Helloworlllld/mengsheng_cup_2022_b/(list of files, drawings)

Other design files:
MSB.eprj
