Helloworlllld/mengsheng_cup_2022_b/MSB/Core/Inc/main.h

#define LED_Pin GPIO_PIN_13
#define LED_GPIO_Port GPIOC
#define KEY_Pin GPIO_PIN_0
#define KEY_GPIO_Port GPIOA
#define B_LED_Pin GPIO_PIN_7
#define B_LED_GPIO_Port GPIOA
#define G_LED_Pin GPIO_PIN_0
#define G_LED_GPIO_Port GPIOB
#define R_LED_Pin GPIO_PIN_1
#define R_LED_GPIO_Port GPIOB
#define LCD_SCL_Pin GPIO_PIN_10
#define LCD_SCL_GPIO_Port GPIOB
#define LCD_SDA_Pin GPIO_PIN_15
#define LCD_SDA_GPIO_Port GPIOB
#define LCD_RES_Pin GPIO_PIN_15
#define LCD_RES_GPIO_Port GPIOA
#define LCD_DC_Pin GPIO_PIN_3
#define LCD_DC_GPIO_Port GPIOB
#define LCD_CS_Pin GPIO_PIN_4
#define LCD_CS_GPIO_Port GPIOB
#define LCD_BLK_Pin GPIO_PIN_5
#define LCD_BLK_GPIO_Port GPIOB
#define T_INT_Pin GPIO_PIN_8
#define T_INT_GPIO_Port GPIOB
#define T_INT_EXTI_IRQn EXTI9_5_IRQn
#define T_LED_PWM_Pin GPIO_PIN_9
#define T_LED_PWM_GPIO_Port GPIOB
