Helloworlllld/mengsheng_cup_2022_b/MSB/Core/Inc/Lcd_Driver.h

//////////////////////////////////////////////////////////////////////////////////	 
//本程序只供学习使用，未经作者许可，不得用于其它任何用途
//  功能描述   : 1.8寸LCD 4接口演示例程(STM32系列)
/******************************************************************************
//本程序适用与STM32F103C8
//              GND   电源地
//              VCC   接5V或3.3v电源
//              SCL   接PA5（SCL）
//              SDA   接PA7（SDA）
//              RES   接PB0
//              DC    接PB1
//              CS    接PA4 
//				BL	  接PB10
*******************************************************************************/

#define RED  	0xf800
#define GREEN	0x07e0
#define BLUE 	0x001f
#define WHITE	0xffff
#define BLACK	0x0000
#define YELLOW  0xFFE0
#define GRAY0   0xEF7D   	    //灰色0 3165 00110 001011 00101
#define GRAY1   0x8410      	//灰色1      00000 000000 00000
#define GRAY2   0x4208      	//灰色2  1111111111011111



/*useless definations
#define LCD_CTRLA   	  	GPIOA		//定义TFT数据端口
#define LCD_CTRLB   	  	GPIOB		//定义TFT数据端口



#define LCD_SCL        	GPIO_Pin_5	//PB13--->>TFT --SCL/SCK
#define LCD_SDA        	GPIO_Pin_7	//PB15 MOSI--->>TFT --SDA/DIN
#define LCD_CS        	GPIO_Pin_4  //MCU_PB11--->>TFT --CS/CE

#define LCD_LED        	GPIO_Pin_10  //MCU_PB9--->>TFT --BL
#define LCD_RS         	GPIO_Pin_1	//PB11--->>TFT --RS/DC
#define LCD_RST     	GPIO_Pin_0	//PB10--->>TFT --RST
*/
//#define LCD_CS_SET(x) LCD_CTRL->ODR=(LCD_CTRL->ODR&~LCD_CS)|(x ? LCD_CS:0)

//液晶控制口置1操作语句宏定义
#define	LCD_SCL_SET  	HAL_GPIO_WritePin(LCD_SCL_GPIO_Port,LCD_SCL_Pin,GPIO_PIN_SET)    
#define	LCD_SDA_SET  	HAL_GPIO_WritePin(LCD_SDA_GPIO_Port,LCD_SDA_Pin,GPIO_PIN_SET)  
#define	LCD_CS_SET  	HAL_GPIO_WritePin(LCD_CS_GPIO_Port,LCD_CS_Pin,GPIO_PIN_SET)

    
#define	LCD_LED_SET  	HAL_GPIO_WritePin(LCD_BLK_GPIO_Port,LCD_BLK_Pin,GPIO_PIN_SET) 
#define	LCD_RS_SET  	HAL_GPIO_WritePin(LCD_DC_GPIO_Port,LCD_DC_Pin,GPIO_PIN_SET)
#define	LCD_RST_SET  	HAL_GPIO_WritePin(LCD_RES_GPIO_Port,LCD_RES_Pin,GPIO_PIN_SET)
//液晶控制口置0操作语句宏定义
#define	LCD_SCL_CLR  	HAL_GPIO_WritePin(LCD_SCL_GPIO_Port,LCD_SCL_Pin,GPIO_PIN_RESET)  
#define	LCD_SDA_CLR  	HAL_GPIO_WritePin(LCD_SDA_GPIO_Port,LCD_SDA_Pin,GPIO_PIN_RESET)  
#define	LCD_CS_CLR  	HAL_GPIO_WritePin(LCD_CS_GPIO_Port,LCD_CS_Pin,GPIO_PIN_RESET)
    
#define	LCD_LED_CLR  	HAL_GPIO_WritePin(LCD_BLK_GPIO_Port,LCD_BLK_Pin,GPIO_PIN_RESET)
#define	LCD_RST_CLR  	HAL_GPIO_WritePin(LCD_DC_GPIO_Port,LCD_DC_Pin,GPIO_PIN_RESET)
#define	LCD_RS_CLR  	HAL_GPIO_WritePin(LCD_RES_GPIO_Port,LCD_RES_Pin,GPIO_PIN_RESET) 

#define LCD_DATAOUT(x) LCD_DATA->ODR=x; //数据输出
#define LCD_DATAIN     LCD_DATA->IDR;   //数据输入

#define LCD_WR_DATA(data){\
LCD_RS_SET;\
LCD_CS_CLR;\
LCD_DATAOUT(data);\
LCD_WR_CLR;\
LCD_WR_SET;\
LCD_CS_SET;\
} 



void LCD_GPIO_Init(void);
void Lcd_WriteIndex(uint8_t Index);
void Lcd_WriteData(uint8_t Data);
void Lcd_WriteReg(uint8_t Index,uint8_t Data);
uint16_t Lcd_ReadReg(uint8_t LCD_Reg);
void Lcd_Reset(void);
void Lcd_Init(void);
void Lcd_Clear(uint16_t Color);
void Lcd_SetXY(uint16_t x,uint16_t y);
void Gui_DrawPoint(uint16_t x,uint16_t y,uint16_t Data);
unsigned int Lcd_ReadPoint(uint16_t x,uint16_t y);
void Lcd_SetRegion(uint16_t x_start,uint16_t y_start,uint16_t x_end,uint16_t y_end);
void LCD_WriteData_16Bit(uint16_t Data);
