Helloworlllld/mengsheng_cup_2022_b/MSB/Core/Inc/HUAJI.h

const unsigned char gImage_HUAJI[3480] = { /* 0X10,0X10,0X00,0X3C,0X00,0X1D,0X01,0X1B, */
0XFF,0XFF,0XF7,0XBE,0XFF,0XFF,0XFF,0XDF,0XF7,0XBE,0XF7,0X9D,0XFF,0XBE,0XFF,0XFE,
0XF7,0X9C,0XFF,0XDD,0XFF,0XBC,0XFF,0XFD,0XFF,0XDD,0XFF,0XDC,0XF7,0XBB,0XEF,0X9A,
0XFF,0XFC,0XFF,0XDD,0XFF,0XFD,0XFF,0XFE,0XF7,0XBD,0XFF,0XFF,0XF7,0XDE,0XEF,0XDE,
0XEF,0XDE,0XF7,0XFE,0XFF,0XFF,0XFF,0XFF,0XFF,0XDF,0XFF,0XBF,0XFF,0XBF,0XF7,0XBF,
0XFF,0XDF,0XFF,0XDE,0XFF,0XFE,0XFF,0XDD,0XFF,0XDD,0XE7,0X1A,0XF7,0X7B,0XFF,0XFD,
0XFF,0XDD,0XEF,0X7C,0XFF,0XFE,0XEF,0XBD,0XF7,0XFE,0XF7,0XFF,0XF7,0XFF,0XF7,0XFF,
0XEF,0XFF,0XEF,0XFF,0XEF,0XFF,0XEF,0XDF,0XF7,0XDF,0XF7,0XFF,0XF7,0XDF,0XF7,0XFF,
0XFF,0XFF,0XF7,0XFF,0XF7,0XDF,0XF7,0XFF,0XFF,0XFE,0XFF,0XFE,0XEF,0X7D,0XEF,0X5C,
0XFF,0XBE,0XFF,0XDE,0XFF,0XFE,0XEF,0X5B,0XFF,0XDC,0XFF,0XDD,0XFF,0XDC,0XFF,0XBC,
0XFF,0XDC,0XFF,0XDC,0XFF,0XDB,0XFF,0XFC,0XF7,0XBB,0XFF,0XFD,0XFF,0XDD,0XFF,0XBD,
0XFF,0XBD,0XFF,0XDE,0XF7,0XBD,0XF7,0XFF,0XF7,0XDE,0XF7,0XFE,0XF7,0XFF,0XFF,0XFF,
0XFF,0XFF,0XFF,0XFF,0XFF,0XDF,0XF7,0X9E,0XFF,0XDF,0XFF,0XDE,0XFF,0XDE,0XFF,0XFE,
0XCE,0X57,0XAD,0X73,0XB5,0X93,0XDE,0XD8,0XFF,0XDC,0XFF,0XFD,0XF7,0XBD,0XFF,0XFE,
0XF7,0XFE,0XEF,0XBE,0XEF,0XDE,0XF7,0XFF,0XF7,0XFF,0XEF,0XDE,0XEF,0XDF,0XF7,0XFF,
0XF7,0XFF,0XF7,0XFF,0XF7,0XDF,0XF7,0XFF,0XFF,0XFF,0XF7,0XFF,0XF7,0XDF,0XF7,0XFF,
0XFF,0XDE,0XFF,0XFE,0XF7,0XBE,0XF7,0XBD,0XFF,0XDE,0XFF,0XBD,0XFF,0X9C,0XFF,0XBC,
0XF7,0X7A,0XF7,0X7A,0XF7,0X5A,0XEE,0XF8,0XEF,0X18,0XEF,0X18,0XEF,0X38,0XFF,0XBA,
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
0XFF,0XFF,0XFF,0XFF,0XFF,0XFF,0XFF,0XFF,0XFF,0XFF,0XFF,0XFF,0XFF,0XFF,0XFF,0XFF,
0XFF,0XFE,0XFF,0XFE,0XFF,0XFE,0XFF,0XDE,0XFF,0XDE,0XFF,0XDE,0XFF,0XDE,0XFF,0XBD,
0XFF,0X9B,0XF7,0X9B,0XFF,0XBB,0XF7,0X5A,0XEF,0X39,0XF7,0X7A,0XF7,0XBB,0XFF,0XFD,
0XFF,0XDD,0XFF,0XFF,0XFF,0XFF,0XFF,0XFF,};
