Helloworlllld/mengsheng_cup_2022_b/MSB/Core/Inc/Picture.h

//16位BMP 40X40 QQ图像取模数据
//Image2LCD取模选项设置
//水平扫描
//16位
//40X40
//不包含图像头数据
//自左至右
//自顶至底
//低位在前
const unsigned char gImage_qq[3200] = { /*0X00,0X10,0X28,0X00,0X28,0X00,0X01,0X1B,*/
0XDB,0XDE,0X5D,0XEF,0X5D,0XEF,0X7D,0XEF,0X5D,0XEF,0X5D,0XEF,0X5D,0XEF,0X5D,0XEF,
0X5D,0XEF,0X5D,0XEF,0X5D,0XEF,0X5D,0XEF,0X5D,0XEF,0X5D,0XEF,0X5D,0XEF,0XBE,0XF7,
0XFF,0XFF,0XDE,0XFF,0X38,0XC6,0X92,0X8C,0X8E,0X6B,0X6E,0X6B,0X10,0X7C,0X96,0XAD,
0X3C,0XE7,0XFF,0XFF,0XFF,0XFF,0X7D,0XEF,0X5D,0XEF,0X5D,0XEF,0X5D,0XEF,0X5D,0XEF,
0X5D,0XEF,0X5D,0XEF,0X5D,0XEF,0X5D,0XEF,0X5D,0XEF,0X5D,0XEF,0X5D,0XEF,0X5D,0XEF,
0X5D,0XEF,0XFF,0XFF,0XFF,0XFF,0XFF,0XFF,0XFF,0XFF,0XFF,0XFF,0XFF,0XFF,0XFF,0XFF,
0XFF,0XFF,0XFF,0XFF,0XFF,0XFF,0XFF,0XFF,0XFF,0XFF,0XFF,0XFF,0XFF,0XFF,0X5D,0XEF,
0X15,0X9D,0X4F,0X63,0X6C,0X42,0X0A,0X32,0X88,0X29,0X46,0X19,0X25,0X19,0X45,0X21,
0XE8,0X31,0X8E,0X6B,0X18,0XBE,0XFF,0XFF,0XFF,0XFF,0XFF,0XFF,0XFF,0XFF,0XFF,0XFF,
0XFF,0XFF,0XFF,0XFF,0XFF,0XFF,0XFF,0XFF,0XFF,0XFF,0XFF,0XFF,0XFF,0XFF,0XFF,0XFF,
0X5D,0XEF,0XFF,0XFF,0XFF,0XFF,0XFF,0XFF,0XFF,0XFF,0XFF,0XFF,0XFF,0XFF,0XFF,0XFF,
0XFF,0XFF,0XFF,0XFF,0XFF,0XFF,0XFF,0XFF,0XFF,0XFF,0XDF,0XFF,0XF5,0X9C,0X0F,0X53,
0X10,0X4B,0X51,0X53,0X0F,0X4B,0X6C,0X3A,0XE9,0X31,0X67,0X21,0X25,0X19,0XE4,0X10,
0XA3,0X08,0X62,0X00,0X83,0X08,0X8A,0X4A,0X59,0XC6,0XFF,0XFF,0XFF,0XFF,0XFF,0XFF,
0XFF,0XFF,0XFF,0XFF,0XFF,0XFF,0XFF,0XFF,0XFF,0XFF,0XFF,0XFF,0XFF,0XFF,0XFF,0XFF,
0X5D,0XEF,0XFF,0XFF,0XFF,0XFF,0XFF,0XFF,0XFF,0XFF,0XFF,0XFF,0XFF,0XFF,0XFF,0XFF,
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
0XA4,0XC2,0X09,0XB3,0XD2,0XBC,0X9E,0XF7,0XFF,0XFF,0XFF,0XFF,0XFF,0XFF,0XFB,0XE6,
0X0E,0XB4,0XA6,0XBA,0X83,0XD2,0XE3,0XE2,0X02,0XEB,0X22,0XEB,0X22,0XE3,0X03,0XDB,
0XE4,0XD2,0X6A,0XC3,0XB6,0XD5,0XFF,0XFF,0XFF,0XFF,0XFF,0XFF,0XFF,0XFF,0XFF,0XFF,
};
